jrfoell/arduino-midi-3-pedal/next-steps.md

# Next Steps

## ✅ 1. Measure resistor values

Resistance measured across pedal connector:

- Right pedal only (damper / potentiometer) — 0–12kΩ range
- Middle pedal only (sostenuto) — 10kΩ
- Left pedal only (soft / una corda) — 5.6kΩ
- Middle + Left together — 3.6kΩ (matches parallel calculation)

## ✅ 2. External resistors required

The Sleeve conductor is the 3.3V power rail — connect it to the Feather's 3.3V
pin through a small series resistor (R1, **330Ω** or similar) for fault
protection. Keep R1 small: because it sits in series with the internal pedal
resistors and the pull-down, a large R1 compresses all the voltage levels
together and makes them hard to distinguish.

The Tip (A2) and Ring (A3) signal pins each need an external **pull-down
resistor to GND** (start with **10kΩ** each). Without pull-downs the analog
pins float and readings will be meaningless. With Sleeve at 3.3V, pressing a
pedal pulls the signal pin up through the internal pedal resistor, forming a
voltage divider with the pull-down. Do not use pull-ups on the signal pins —
with Sleeve already at 3.3V, a pull-up would put both ends of the divider at
the same voltage and eliminate all differentiation.

## ✅ 3. Potentiometer does not affect Ring baseline

Initial concern was that the damper potentiometer body spans Ring–Sleeve and
would shift the Ring baseline continuously. Testing confirmed this is not the
case — Ring reads ~60 at rest regardless of damper pedal position. The damper
pot is isolated from the Ring circuit; only its wiper output appears on Tip.
Middle and Left pedal thresholds are stable and fixed calibration values work.

## ✅ 4. Initial ADC readings confirmed

First bench test (wired per schematic). These values are encoded as compile-time
defaults used when no EEPROM calibration has been saved:

| Pedal state | Tip (A2) | Ring (A3) |
|---|---|---|
| All released | — | ~60 |
| Damper fully pressed | ~1850–1900 | — |
| Damper at rest | ~3900–4000 | — |
| Middle only | — | ~1900–2000 |
| Left only | — | ~2400–2500 |
| Middle + Left | — | ~2800–2900 |

Note: Tip reads **high at rest and low when pressed** (pot wiper sits near the
Sleeve/3.3V end when damper is released; moves toward Ring/GND end when pressed).

## 5. Code architecture

- **Platform: Arduino (C++) only.** CircuitPython is explicitly avoided — it is
  too slow for low-latency MIDI requirements.
- **All settable constants** (pins, MIDI channel, defaults, timing) live in
  `arduino-midi-3-pedal.ino` for easy access.
- **Related functionality** is split into header files included by the .ino:
  - `calibration.h` — `CalibrationData` struct, EEPROM read/write,
    NeoPixel helpers, `runCalibration()`, `pedalHeldAtBoot()`
  - `status.h` — `updateStatusLed()`: red = no pedal, off = pedal/DIN assumed, green = pedal + USB MIDI confirmed
  - Future: `pedal_decode.h` — voltage-to-state decode logic
  - Future: `midi_output.h` — MIDI CC send helpers (hardware DIN + USB host)
- Goal: keep the main .ino under ~80 lines; no 1000-line files.

## ✅ 6. Calibration sequence (implemented in calibration.h)

Triggered by holding the left or middle pedal (or both) when the M4 powers on.
The Feather M4 Express has no user-programmable button; the reset button is not
available for user code. Calibration is checked once in `setup()` immediately
after calibration data loads.

**Boot / trigger sequence:**

| LED | Condition |
|---|---|
| Off | No pedal held at boot — normal startup |
| Solid blue | Pedal detected held — counting down `CALIB_HOLD_MS` (2 s) |
| Fast blink blue | Hold complete — release pedal to begin calibration |
| Off (pedal released) | Enters calibration sequence below |
| Off (pedal released early) | Hold cancelled — normal startup |

**Calibration sequence** (right-to-left pedal order):

| LED | Action |
|---|---|
| Slow blink blue | Calibration start. Release all pedals to begin — reads baseline (2 s) |
| Slow blink violet → fast blink violet | Press + hold right / damper pedal, release when fast |
| Slow blink red → fast blink red | Press + hold middle / sostenuto pedal, release when fast |
| Slow blink orange → fast blink orange | Press + hold left / soft pedal, release when fast |
| Slow blink yellow → fast blink yellow | Press + hold middle + left together, release when fast |
| Blink green | Writing to EEPROM — then off |

On power-up, EEPROM is checked for a valid magic number (`0xFEED1234`). If
absent or corrupt, compile-time defaults are used automatically.

## 7. Next: MIDI output and pedal decode logic

MIDI CC messages must be sent simultaneously on two outputs:

**Hardware DIN MIDI** (MIDI FeatherWing):
- Serial1 @ 31250 baud via *MIDI Library* by Forty Seven Effects

**USB Host MIDI** (USB Host FeatherWing with MAX3421E):
- Library: *Adafruit TinyUSB* — `CFG_TUH_MIDI` already enabled, no config edit needed
- CS → pin 10, INT → pin 9, hardware SPI (pins 23/24/25)
- `tuh_task()` must be called every loop iteration
- Keyboards connect to the USB Host FeatherWing as USB MIDI devices

**Pedal decode:**
- Read Ring (A3) → decode middle/left switch states using thresholds derived
  from calibration data (`threshNoneToMiddle`, `threshMiddleToLeft`,
  `threshLeftToBoth`).
- Read Tip (A2) → map damper position to CC 64 value 0–127, accounting for
  inverted range (high at rest, low when pressed).
- Debounce middle and left switches with `millis()`-based timing.
- Send CC 64 (damper), CC 66 (sostenuto), CC 67 (soft) on state changes to
  both outputs via a single `sendCC()` function in `midi_output.h`.
