jrfoell/arduino-midi-3-pedal/pedal-schematic.png

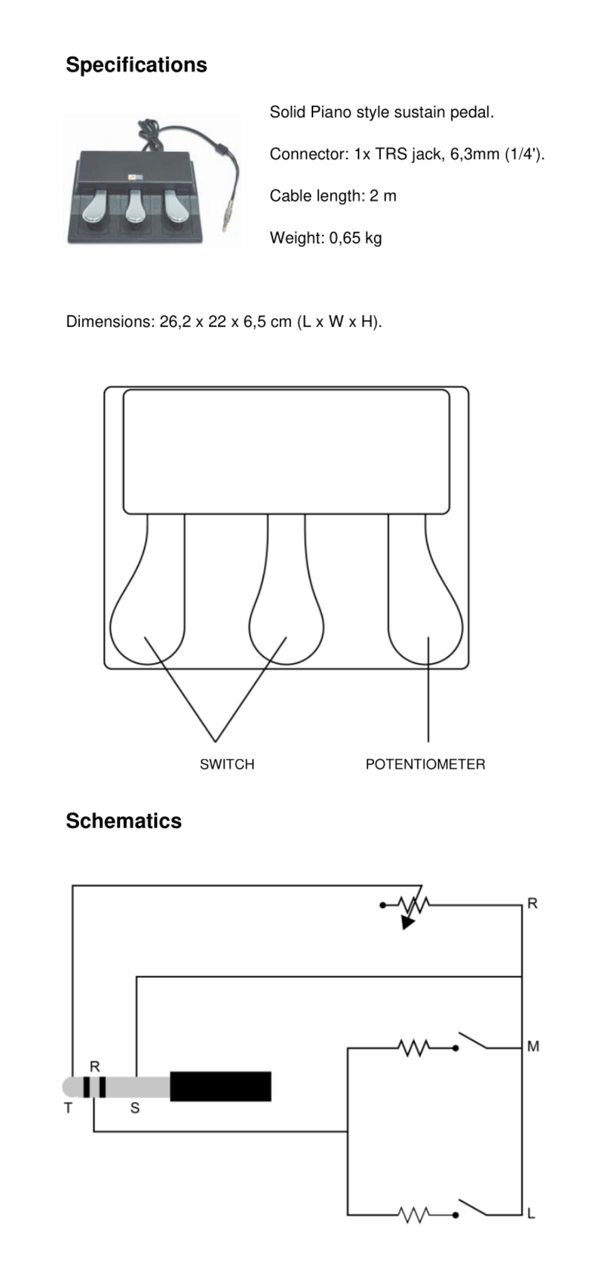
pedal-schematic.png
