jrfoell/arduino-midi-3-pedal/midi_output.h

// midi_output.h
// MIDI I/O via hardware DIN (MIDI FeatherWing / Serial1) and
// USB host (USB Host FeatherWing / MAX3421E + TinyUSB).
//
// Exposes:
//   initMidi()         — call once in setup(), after Serial.begin()
//   usbMidiTask()      — call every loop(); services DIN MIDI input + USB host
//   sendCC(ch, cc, v)  — sends to all enabled outputs
//   usbMidiConnected   — true when a USB MIDI device is mounted

#pragma once

#include <SPI.h>
#include <Adafruit_TinyUSB.h>
#include <MIDI.h>
#include "debug.h"

// ─── Hardware DIN MIDI (Serial1 via MIDI FeatherWing) ────────────────────────
// Requires HARDWARE_MIDI defined in the .ino (before all includes).
#ifdef HARDWARE_MIDI
  MIDI_CREATE_INSTANCE(HardwareSerial, Serial1, hwMidi);
  #define MIDI_BEGIN()   hwMidi.begin(MIDI_CHANNEL_OMNI);
  #define MIDI_THRU_ON() hwMidi.turnThruOn();
#else
  #define MIDI_BEGIN()   ((void)0)
  #define MIDI_THRU_ON() ((void)0)
#endif

// ─── USB host (MAX3421E) ─────────────────────────────────────────────────────
// Requires HARDWARE_USB defined in the .ino (before all includes).
#ifdef HARDWARE_USB
  #define USB_HOST_BEGIN() USBHost.begin(1);

  #define PIN_USB_CS   10   // Chip select
  #define PIN_USB_INT   9   // Interrupt

  static Adafruit_USBH_Host USBHost(&SPI, PIN_USB_CS, PIN_USB_INT);

  typedef struct {
    tusb_desc_device_t desc_device;
    uint16_t manufacturer[32];
    uint16_t product[48];
    uint16_t serial[16];
    bool mounted;
  } dev_info_t;

  // CFG_TUH_DEVICE_MAX is defined by tusb_config header
  dev_info_t dev_info[CFG_TUH_DEVICE_MAX] = { 0 };

  // Interface index set by tuh_midi_mount_cb; used in all tuh_midi_* calls.
  static uint8_t _usbMidiIdx = 255;

  // True when a USB MIDI device is mounted and ready.
  static bool usbMidiConnected = false;

#else
  #define USB_HOST_BEGIN() ((void)0)
  // No USB host hardware — always report disconnected.
  static bool usbMidiConnected = false;
#endif

// ─── Shared note / LED tracking ───────────────────────────────────────────────
// Counts held notes across DIN MIDI and USB MIDI inputs combined.
// LED_BUILTIN is lit (LOW on Feather M4) while at least one note is held.
static int _activeNotes = 0;

static void _noteOn(uint8_t ch, uint8_t note, uint8_t vel) {
  if (_activeNotes == 0) digitalWrite(LED_BUILTIN, LOW);
  _activeNotes++;
  DEBUG_PRINT("NoteOn   ch="); DEBUG_PRINT(ch);
  DEBUG_PRINT(" note=");       DEBUG_PRINT(note);
  DEBUG_PRINT(" vel=");        DEBUG_PRINTLN(vel);
}

static void _noteOff(uint8_t ch, uint8_t note) {
  if (_activeNotes > 0) _activeNotes--;
  if (_activeNotes == 0) digitalWrite(LED_BUILTIN, HIGH);
  DEBUG_PRINT("NoteOff  ch="); DEBUG_PRINT(ch);
  DEBUG_PRINT(" note=");       DEBUG_PRINTLN(note);
}

// ─── DIN MIDI note callbacks ──────────────────────────────────────────────────
#ifdef HARDWARE_MIDI
  static void _hwNoteOn(byte ch, byte note, byte vel) {
    _noteOn(ch, note, vel);
  }
  static void _hwNoteOff(byte ch, byte note, byte vel) {
    (void)vel;
    _noteOff(ch, note);
  }
#endif

// ─── Init ────────────────────────────────────────────────────────────────────

// Must be called after Serial.begin() — see Adafruit device_info_max3421e.
static void initMidi() {
  MIDI_BEGIN();
  MIDI_THRU_ON();  // DIN IN → DIN OUT thru (handled by MIDI Library)
  #ifdef HARDWARE_MIDI
    hwMidi.setHandleNoteOn(_hwNoteOn);
    hwMidi.setHandleNoteOff(_hwNoteOff);
  #endif
  USB_HOST_BEGIN();
}

// ─── Send ─────────────────────────────────────────────────────────────────────

static void sendCC(uint8_t channel, uint8_t cc, uint8_t value) {
  #ifdef HARDWARE_MIDI
    hwMidi.sendControlChange(cc, value, channel);
  #endif

  #ifdef HARDWARE_USB
    if (usbMidiConnected) {
      // 4-byte USB MIDI 1.0 packet: [CIN|cable, status, data1, data2]
      // CIN 0x0B = Control Change (matches high nibble of 0xBx status byte).
      // Uses packet_write rather than stream_write to avoid a silent early-exit
      // in stream_write when tx_cable_count == 0 on some devices.
      uint8_t packet[4] = {
        0x0B,
        (uint8_t)(0xB0 | (channel - 1)),
        cc,
        value
      };
      tuh_midi_packet_write(_usbMidiIdx, packet);
      tuh_midi_write_flush(_usbMidiIdx);
    }
  #endif
}

// ─── Task (call every loop) ───────────────────────────────────────────────────

static void usbMidiTask() {
  #ifdef HARDWARE_MIDI
    hwMidi.read();
  #endif

  #ifdef HARDWARE_USB
    USBHost.task();

    if (!usbMidiConnected) return;

    // Drain all available MIDI packets from the device.
    // USB MIDI packets are 4 bytes: [header, status, data1, data2]
    uint8_t packet[4];
    while (tuh_midi_packet_read(_usbMidiIdx, packet)) {
      uint8_t status = packet[1];
      uint8_t type   = status & 0xF0;
      uint8_t ch     = (status & 0x0F) + 1;  // convert to 1-based

      if (type == 0x90 && packet[3] > 0) {   // NoteOn (velocity 0 = NoteOff)
        _noteOn(ch, packet[2], packet[3]);
      } else if (type == 0x80 || (type == 0x90 && packet[3] == 0)) {
        _noteOff(ch, packet[2]);
      }

      // USB IN → DIN OUT thru. Pedal CCs queue in the same Serial1 TX buffer.
      #ifdef HARDWARE_MIDI
        if (type == 0xC0 || type == 0xD0) {
          // 2-byte: Program Change, Channel Pressure
          Serial1.write(packet[1]);
          Serial1.write(packet[2]);
        } else if (type >= 0x80 && type <= 0xE0) {
          // 3-byte: Note Off/On, Poly Pressure, CC, Pitch Bend
          Serial1.write(packet[1]);
          Serial1.write(packet[2]);
          Serial1.write(packet[3]);
        }
      #endif
    }
  #endif
}

// ─── USB host callbacks ───────────────────────────────────────────────────────
#ifdef HARDWARE_USB
  extern "C" {
    // Generic — fires for any USB device class
    void tuh_mount_cb(uint8_t daddr) {
      DEBUG_PRINT("USB: device mounted  addr=");
      DEBUG_PRINTLN(daddr);
    }

    void tuh_umount_cb(uint8_t daddr) {
      DEBUG_PRINT("USB: device removed  addr=");
      DEBUG_PRINTLN(daddr);
    }

    // MIDI class — fires once the MIDI host driver has set up the device
    void tuh_midi_mount_cb(uint8_t idx, const tuh_midi_mount_cb_t *data) {
      _usbMidiIdx      = idx;
      usbMidiConnected = true;
      DEBUG_PRINT("USB MIDI: device ready  idx="); DEBUG_PRINT(idx);
      DEBUG_PRINT(" rx_cables=");                  DEBUG_PRINT(data->rx_cable_count);
      DEBUG_PRINT(" tx_cables=");                  DEBUG_PRINTLN(data->tx_cable_count);
    }

    void tuh_midi_umount_cb(uint8_t idx) {
      (void)idx;
      _usbMidiIdx      = 255;
      usbMidiConnected = false;
      DEBUG_PRINTLN("USB MIDI: device removed");
    }
  }
#endif
