jrfoell/arduino-midi-3-pedal/calibration.h

#pragma once
#include <Adafruit_NeoPixel.h>
#include <FlashStorage_SAMD.h>
#include "colors.h"
#include "debug.h"
#define PIN_TIP          A2   // Right / damper pedal potentiometer wiper
#define PIN_RING         A3   // Middle + left pedal switch network
#define DEFAULT_RING_BASELINE     8
#define DEFAULT_RING_MIDDLE    1960
#define DEFAULT_RING_LEFT      2494
#define DEFAULT_RING_BOTH      2857
#define DEFAULT_TIP_REST       3965
#define DEFAULT_TIP_PRESSED    3050
#define CALIB_HOLD_MS       2000   // Pedal hold duration at boot to trigger calibration (ms)
#define CALIB_READ_MS       2000   // Sampling window per pedal state (ms)
#define CALIB_SLOW_BLINK_MS  500   // Blink half-period: waiting for press
#define CALIB_FAST_BLINK_MS  100   // Blink half-period: signal user to release
#define CALIB_PRESS_MARGIN   300   // Min ADC delta from baseline to detect a press
static const uint32_t CALIB_MAGIC       = 0xFEED1234;
static const int      CALIB_EEPROM_ADDR = 0;
struct CalibrationData {
  uint32_t magic;
  int ringBaseline;   // Ring ADC: all pedals released
  int ringMiddle;     // Ring ADC: middle / sostenuto only
  int ringLeft;       // Ring ADC: left / soft only
  int ringBoth;       // Ring ADC: middle + left together
  int tipRest;        // Tip ADC: damper fully released
  int tipPressed;     // Tip ADC: damper fully pressed
};
inline int threshNoneToMiddle(const CalibrationData& d) {
  return (d.ringBaseline + d.ringMiddle) / 2;
}
inline int threshMiddleToLeft(const CalibrationData& d) {
  return (d.ringMiddle + d.ringLeft) / 2;
}
inline int threshLeftToBoth(const CalibrationData& d) {
  return (d.ringLeft + d.ringBoth) / 2;
}
inline CalibrationData defaultCalibration() {
  CalibrationData d;
  d.magic        = CALIB_MAGIC;
  d.ringBaseline = DEFAULT_RING_BASELINE;
  d.ringMiddle   = DEFAULT_RING_MIDDLE;
  d.ringLeft     = DEFAULT_RING_LEFT;
  d.ringBoth     = DEFAULT_RING_BOTH;
  d.tipRest      = DEFAULT_TIP_REST;
  d.tipPressed   = DEFAULT_TIP_PRESSED;
  return d;
}
inline bool loadCalibration(CalibrationData& data) {
  EEPROM.get(CALIB_EEPROM_ADDR, data);
  return data.magic == CALIB_MAGIC;
}
inline void saveCalibration(const CalibrationData& data) {
  EEPROM.put(CALIB_EEPROM_ADDR, data);
  EEPROM.commit();  // required by FlashStorage_SAMD to flush buffer to NVM
}
static void neoSet(Adafruit_NeoPixel& px, uint32_t color) {
  px.setPixelColor(0, color);
  px.show();
}
static int calibPedalPhase(Adafruit_NeoPixel& px, uint32_t color,
                            int pin, int pressThreshold, bool pressedAbove) {
  long sampleSum   = 0;
  int  sampleCount = 0;
  unsigned long sampleStart = 0;
  bool pressed      = false;
  bool samplingDone = false;
  unsigned long blinkTimer = millis();
  bool blinkOn = true;
  neoSet(px, color);
  while (true) {
    unsigned long now = millis();
    int  val       = analogRead(pin);
    bool isPressed = pressedAbove ? (val > pressThreshold) : (val < pressThreshold);
    unsigned long interval = samplingDone ? CALIB_FAST_BLINK_MS : CALIB_SLOW_BLINK_MS;
    if (now - blinkTimer >= interval) {
      blinkOn = !blinkOn;
      neoSet(px, blinkOn ? color : 0);
      blinkTimer = now;
    }
    if (!pressed && isPressed) {
      pressed     = true;
      sampleStart = now;
    }
    if (pressed && !samplingDone) {
      sampleSum += val;
      sampleCount++;
      if (now - sampleStart >= CALIB_READ_MS) {
        samplingDone = true;
        blinkTimer   = now;  // reset so fast-blink starts cleanly
      }
    }
    if (samplingDone && !isPressed) break;  // pedal released → advance
  }
  neoSet(px, PIXEL_OFF);
  delay(400);
  return (sampleCount > 0) ? (int)(sampleSum / sampleCount) : pressThreshold;
}
inline bool pedalHeldAtBoot(const CalibrationData& calData, Adafruit_NeoPixel& px) {
  int threshold = calData.ringBaseline + CALIB_PRESS_MARGIN;
  if (analogRead(PIN_RING) <= threshold) return false;
  neoSet(px, PIXEL_BLUE);
  unsigned long start = millis();
  while (millis() - start < CALIB_HOLD_MS) {
    if (analogRead(PIN_RING) <= threshold) {
      neoSet(px, PIXEL_OFF);
      return false;
    }
    delay(20);
  }
  unsigned long blinkTimer = millis();
  bool blinkOn = true;
  while (analogRead(PIN_RING) > threshold) {
    unsigned long now = millis();
    if (now - blinkTimer >= CALIB_FAST_BLINK_MS) {
      blinkOn = !blinkOn;
      neoSet(px, blinkOn ? PIXEL_BLUE : PIXEL_OFF);
      blinkTimer = now;
    }
    delay(5);
  }
  neoSet(px, PIXEL_OFF);
  return true;
}
static void runCalibration(Adafruit_NeoPixel& px, CalibrationData& data) {
  DEBUG_PRINTLN("Calibration: initiated");
  while (analogRead(PIN_RING) > (data.ringBaseline + CALIB_PRESS_MARGIN)) {
    delay(10);
  }
  delay(100);
  DEBUG_PRINTLN("Calibration: step 1 — rest (release all pedals)");
  neoSet(px, PIXEL_BLUE);
  {
    long ringSum = 0, tipSum = 0;
    int  count = 0;
    unsigned long start = millis();
    while (millis() - start < CALIB_READ_MS) {
      ringSum += analogRead(PIN_RING);
      tipSum  += analogRead(PIN_TIP);
      count++;
      delay(5);
    }
    data.ringBaseline = (int)(ringSum / count);
    data.tipRest      = (int)(tipSum  / count);
  }
  DEBUG_PRINT_VAL("  ringBaseline", data.ringBaseline);
  DEBUG_PRINT_VAL("  tipRest",      data.tipRest);
  neoSet(px, PIXEL_OFF);
  delay(400);
  DEBUG_PRINTLN("Calibration: step 2 — damper (press right pedal)");
  data.tipPressed = calibPedalPhase(px, PIXEL_VIOLET,
                                     PIN_TIP,
                                     data.tipRest - CALIB_PRESS_MARGIN,
                                     false);
  DEBUG_PRINT_VAL("  tipPressed", data.tipPressed);
  DEBUG_PRINTLN("Calibration: step 3 — sostenuto (press middle pedal)");
  data.ringMiddle = calibPedalPhase(px, PIXEL_RED,
                                     PIN_RING,
                                     data.ringBaseline + CALIB_PRESS_MARGIN,
                                     true);
  DEBUG_PRINT_VAL("  ringMiddle", data.ringMiddle);
  DEBUG_PRINTLN("Calibration: step 4 — soft (press left pedal)");
  data.ringLeft = calibPedalPhase(px, PIXEL_ORANGE,
                                   PIN_RING,
                                   data.ringBaseline + CALIB_PRESS_MARGIN,
                                   true);
  DEBUG_PRINT_VAL("  ringLeft", data.ringLeft);
  DEBUG_PRINTLN("Calibration: step 5 — both (press middle + left together)");
  data.ringBoth = calibPedalPhase(px, PIXEL_YELLOW,
                                   PIN_RING,
                                   data.ringLeft + CALIB_PRESS_MARGIN / 2,
                                   true);
  DEBUG_PRINT_VAL("  ringBoth", data.ringBoth);
  data.magic = CALIB_MAGIC;
  saveCalibration(data);
  DEBUG_PRINTLN("Calibration: complete — values written to flash");
  for (int i = 0; i < 6; i++) {
    neoSet(px, (i % 2 == 0) ? PIXEL_GREEN : PIXEL_OFF);
    delay(200);
  }
  neoSet(px, PIXEL_OFF);
}
