jrfoell/arduino-midi-3-pedal/(commit log)

2026-05-31 Calibration sequence update
2026-05-31 Light NeoPixel red when no pedal attached
2026-05-31 Update to status LED incl. MIDI host
2026-06-01 USB approach based on https://github.com/adafruit/Adafruit_TinyUSB_Arduino/blob/master/examples/DualRole/Simple/device_info_max3421e/device_info_max3421e.ino
